toprakcelikel/V5_Drive-by-wire/Electronics/Readme

Full KiCAD project for DBW circuit board

There is a subdirectory for the power box.
