toprakcelikel/V5_Drive-by-wire/Electronics/Power/Power.kicad_pcb

## KiCad design Electronics/Power/Power.kicad_pcb (2026-08-28)

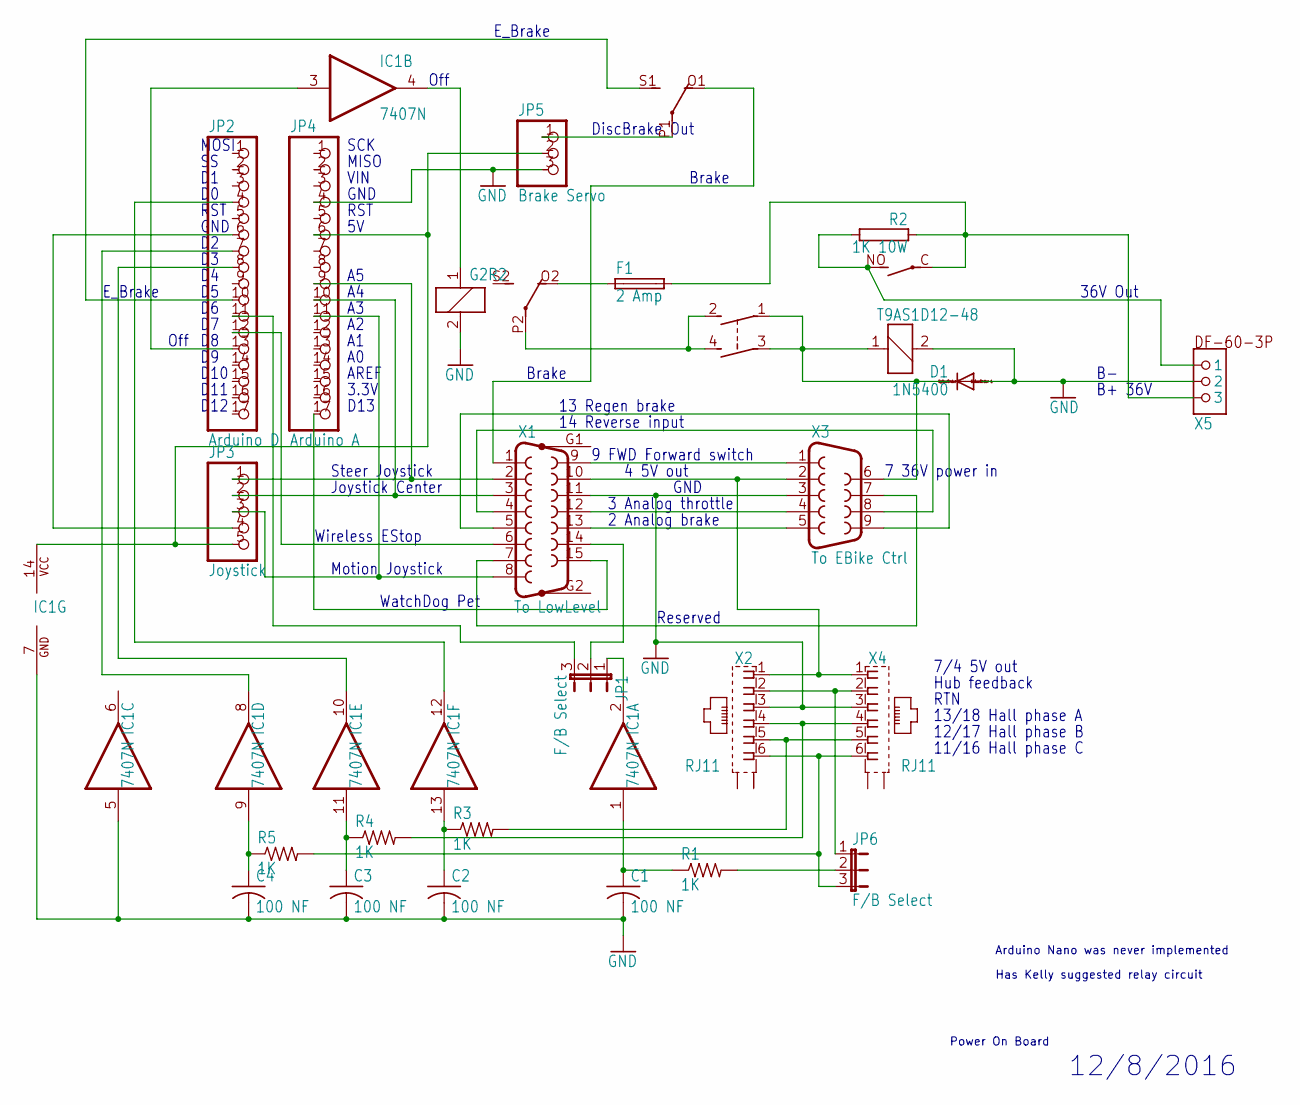
[picture p2: schematic Power.kicad_sch]

Parts:
C1: 100 NF; C050-050X075
C2, C3, C4: 100 NF; C050-024X044
D1: 1N5400; DO201-15
F1: 2 Amp; SH22,5
IC1: 7407N; DIL14
JP1, JP6: F/B Select; JP2
JP2: Arduino D; 1X17
JP3: Joystick; 1X05_90
JP4: Arduino A; 1X17
JP5: Brake Servo; 1X03_90
K1: G2R2
K2: T9AS1D12-48; JT1A-PCB
R1: 1K; 0411_15
R2: 1K 10W; AC07
R3, R4, R5: 1K; 0207_10
SW1: CK-S201
X1: To LowLevel; F15HP
X2, X4: RJ11; XRJK-S-01-6-6-0-2G2-NO
X3: To EBike Ctrl; F09H
X5: HIROSE-DF60-3P-10.16DSA; DF-60-3P-10.16

Connections:
36V_BAT: F1.2, K2.C, R2.1, X5.3A (3), X5.3B (3)
36V_CL: D1.C, K2.1, SW1.1, SW1.3 (P1), X3.6
36V_OUT: K2.NO (S), R2.2, X5.1A (1), X5.1B (1)
36V_SW: K1.P2, SW1.2 (S), SW1.4 (S1)
BRAKE: K1.O1 (O), X1.1
BRK: X1.13, X3.5
BRK_OUT: JP5.1, K1.P1
EBRAKE: JP2.10, K1.S1 (S)
E_RQST: JP2.12, X1.6
F/B: JP1.2, X1.14
FB_SEL: JP6.2, R1.2
FWD: X1.9, X3.1
GND: C1.2, C2.2, C3.2, C4.2, D1.A, IC1.5 (I), IC1.7 (GND), JP4.4, JP5.3, K1.2, K2.2, X1.11, X2.3, X3.3, X4.3, X5.2A (2), X5.2B (2)
GND2: JP2.6, JP3.4
HALLA: R4.2, X2.4, X4.4
HALLB: R3.2, X2.5, X4.5
HALLC: JP6.3, R5.2, X2.6, X4.6
JOY_CEN: JP3.2, JP4.10, X1.3
JOY_MOT: JP3.3, JP4.11, X1.8
JOY_STR: JP3.1, JP4.9, X1.2
LIVE: X1.10, X2.1, X3.2, X4.1
unnamed: IC1.2 (O), JP1.1
unnamed: F1.1, K1.O2 (O)
unnamed: C2.1, IC1.13 (I), R3.1
unnamed: C3.1, IC1.11 (I), R4.1
unnamed: C4.1, IC1.9 (I), R5.1
unnamed: IC1.8 (O), JP2.7
unnamed: IC1.10 (O), JP2.8
unnamed: IC1.12 (O), JP2.4
unnamed: JP1.3, JP2.11
OFF: IC1.3 (I), JP2.13
OFF_DRV: IC1.4 (O), K1.1
RESERVE: X1.7, X3.7
REV: X1.4, X3.8
RGN: X1.5, X3.9
SPD: C1.1, IC1.1 (I), R1.1
SPEED: JP6.1, X2.2, X4.2
THROT: X1.12, X3.4
VCC: IC1.14 (VCC), JP3.5, JP4.6, JP5.2
WDOG: JP4.17, X1.15

Notes on the sheet:
DiscBrake Out
B+ 36V
3.3V
Hub feedback
AREF
Off
GND
Arduino Nano was never implemented
Reserved
Power On Board
Motion Joystick
RTN
Has Kelly suggested relay circuit
36V Out
MISO
13/18 Hall phase A
D12
14 Reverse input
VIN
4 5V out
RST
E_Brake
Joystick Center
D11
2 Analog brake
SCK
13 Regen brake
12/8/2016
WatchDog Pet
Steer Joystick
3 Analog throttle
MOSI
12/17 Hall phase B
Wireless EStop
Brake
7 36V power in
9 FWD Forward switch
D10
11/16 Hall phase C
D13
7/4 5V out

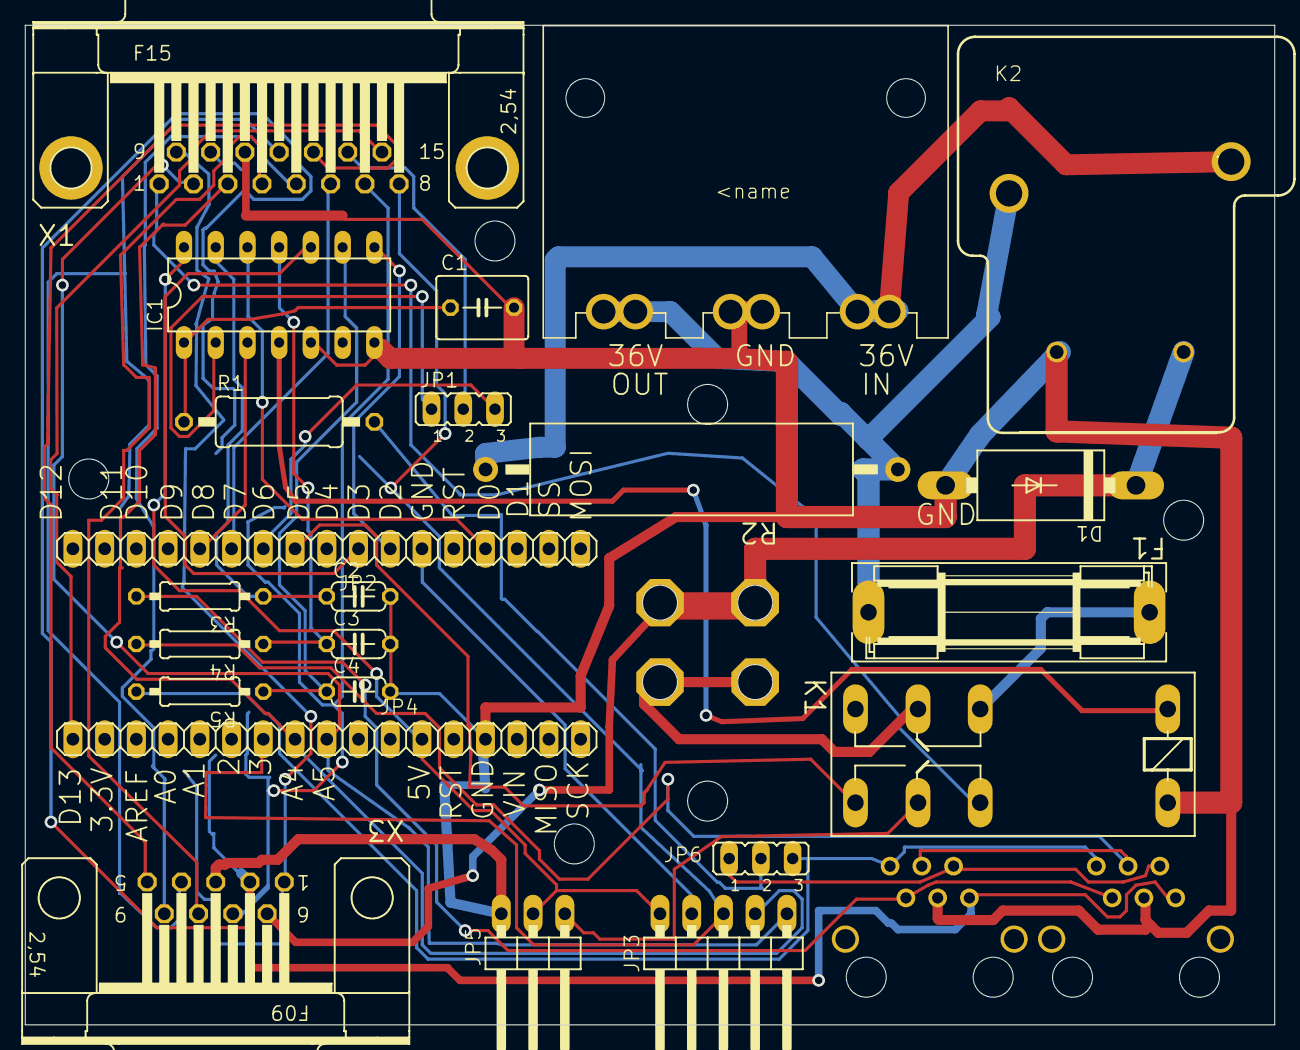
[picture p3: board Power.kicad_pcb from above]

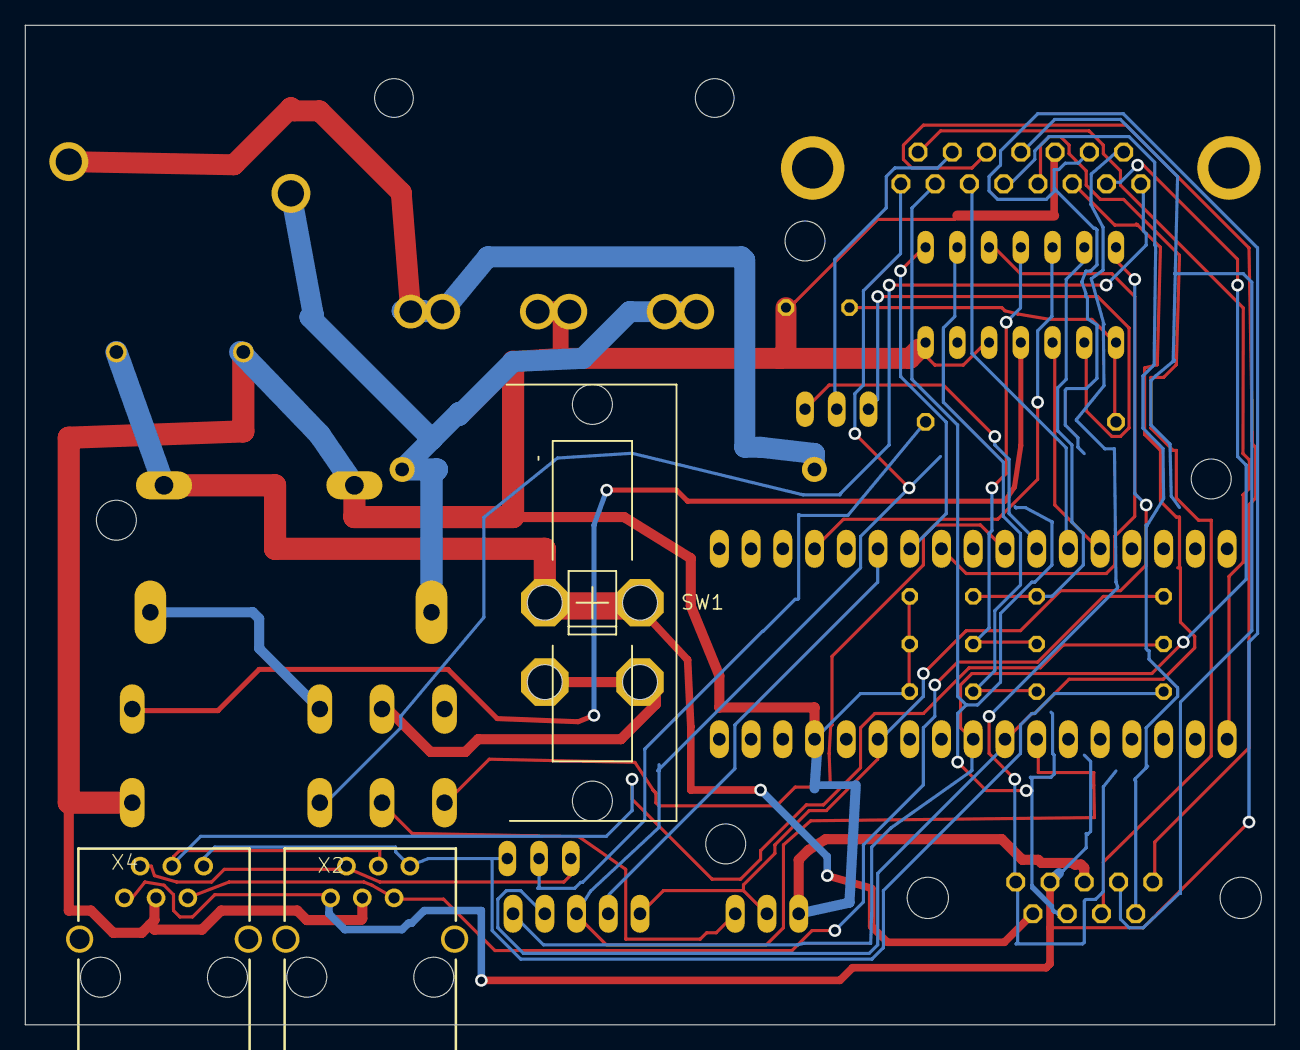
[picture p4: board Power.kicad_pcb from below]

Board: 2 copper layers, 100.0 x 80.0 mm, 30 parts (3 on the bottom side), 40 nets.

Other parts of the board:
UNK_HOLE_0: dummyfp0
UNK_HOLE_1: dummyfp1
UNK_HOLE_2: dummyfp2
UNK_HOLE_3: dummyfp3
