toprakcelikel/V5_Drive-by-wire/(commit log)

2026-08-28 Introduce new subdirectory for power
2026-08-28 Create Readme for Power-on board
2026-08-28 Kicaad files for Power-on board
    These are for version 1, The present system is version 2, but its files have been lost. The circuit for the Kelly ebike controller is similar in both versions.
    [Power.kicad_pcb, Power.kicad_sch]
2026-09-30 Add interactive DBW actuator tests via Serial Monitor
    Keep original controller implementations unchanged and add opt-in diagnostic extensions with minimal compile-time Vehicle hooks. Include controller host regressions, per-command serial PASS/FAIL reporting, and a PR description with reported Due results and pending hardware validation steps. Default to normal firmware.
    [Drive_By_Wire.ino]
2026-10-01 Group DBW diagnostic firmware under src/tests
    Relocate diagnostic sources and the mode header into Arduino's recursively compiled src tree. Update includes, host build paths, and usage documentation while keeping diagnostics disabled by default.
